rverzinkevicius/tacho_speedo/all.jpg

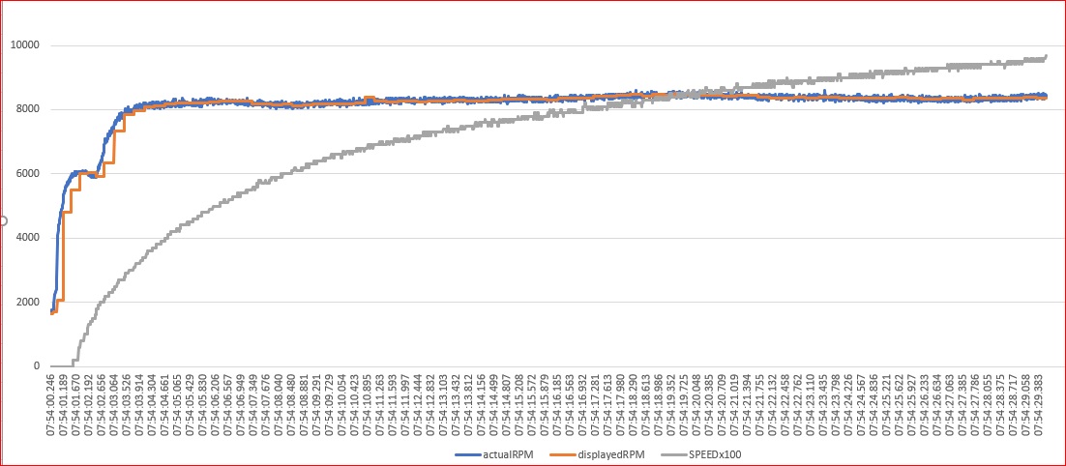
all.jpg
