rverzinkevicius/tacho_speedo/flipped.jpg

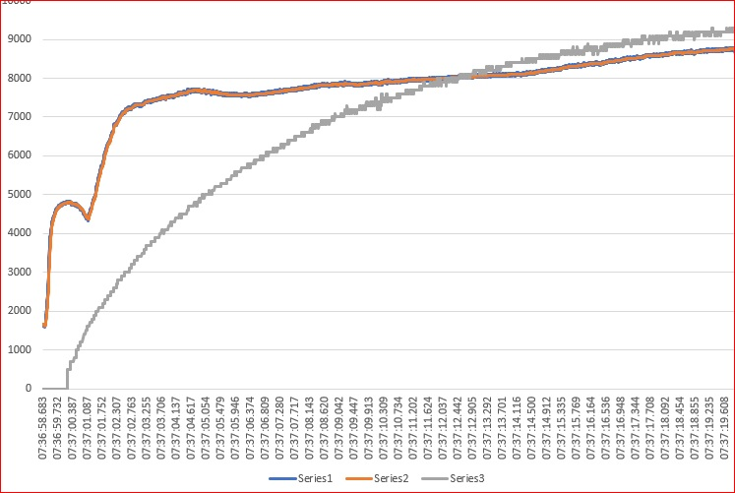
flipped.jpg
