rverzinkevicius/tacho_speedo/SvsR.jpg

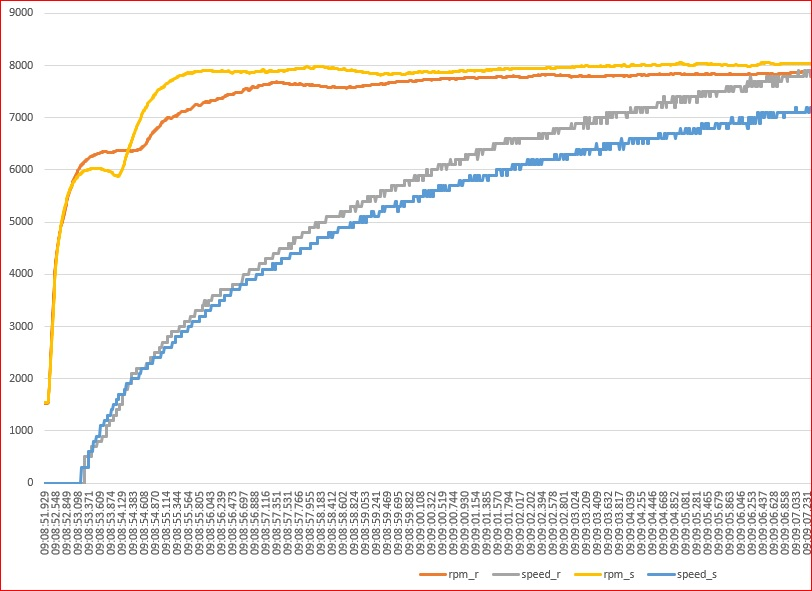
SvsR.jpg
