rverzinkevicius/tacho_speedo/takeoff .jpg

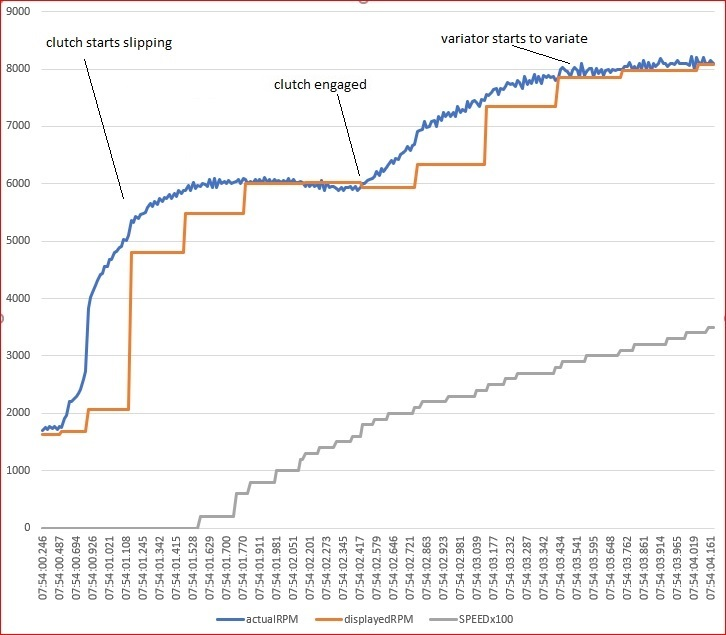
takeoff .jpg
