rverzinkevicius/tacho_speedo/(commit log)

2020-03-16 accuracy/stability updates
    Added additional checks to avoid resets and unnecessary calculations.
    [tacho_speedo.ino]
2020-04-12 Update tacho_speedo.ino
    Interrupts for speed calculation
    0-50 km/h acceleration time
    Some error control
    [tacho_speedo.ino]
2020-07-17 Update tacho_speedo.ino
    using interrupt for RPM
    adding GyverFilters to smooth RPM reading
